BarryPSmith/SierraGliding/README.md

<h1 align=center>Sierra Gliding Weather</h1>

<p align=center>Low Interval Wind Station</p>
