BarryPSmith/SierraGliding/RemoteStation/README.md

Arduino code for the weather stations. Needs cleanup.

Git hash is stored in revid.h. This file is automatically generated by gitver.cmd or gitver.sh.
