BarryPSmith/SierraGliding/docs/img/Solar_panel_1.jpg

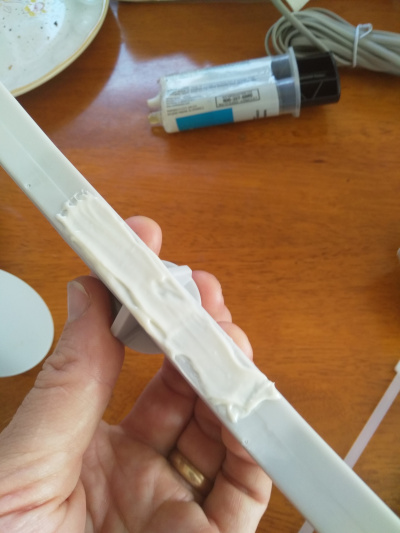
docs/img/Solar_panel_1.jpg
