BarryPSmith/SierraGliding/docs/img/Magnet Installation.jpg

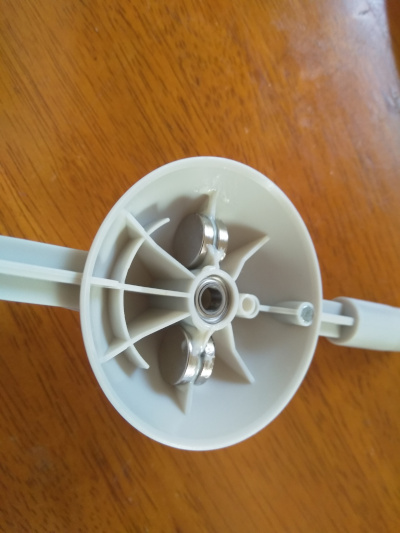
docs/img/Magnet Installation.jpg
