BarryPSmith/SierraGliding/(threads)

Thread 2 (2019-10-12):

Websockets close without traffic

BarryPSmith, 2019-10-12:
Websockets seem to close themselves after a short while without traffic. This might happen if something goes wrong with the server receiving data, or on mobile if the device is put to sleep.

Perhaps have the client periodically check if the websocket has closed and reopen it if necessary

Closed 2020-02-18.
