BarryPSmith/SierraGliding/hardware/main_board/Single_Board.brd

## EAGLE design hardware/main_board/Single_Board.brd (2021-05-05)

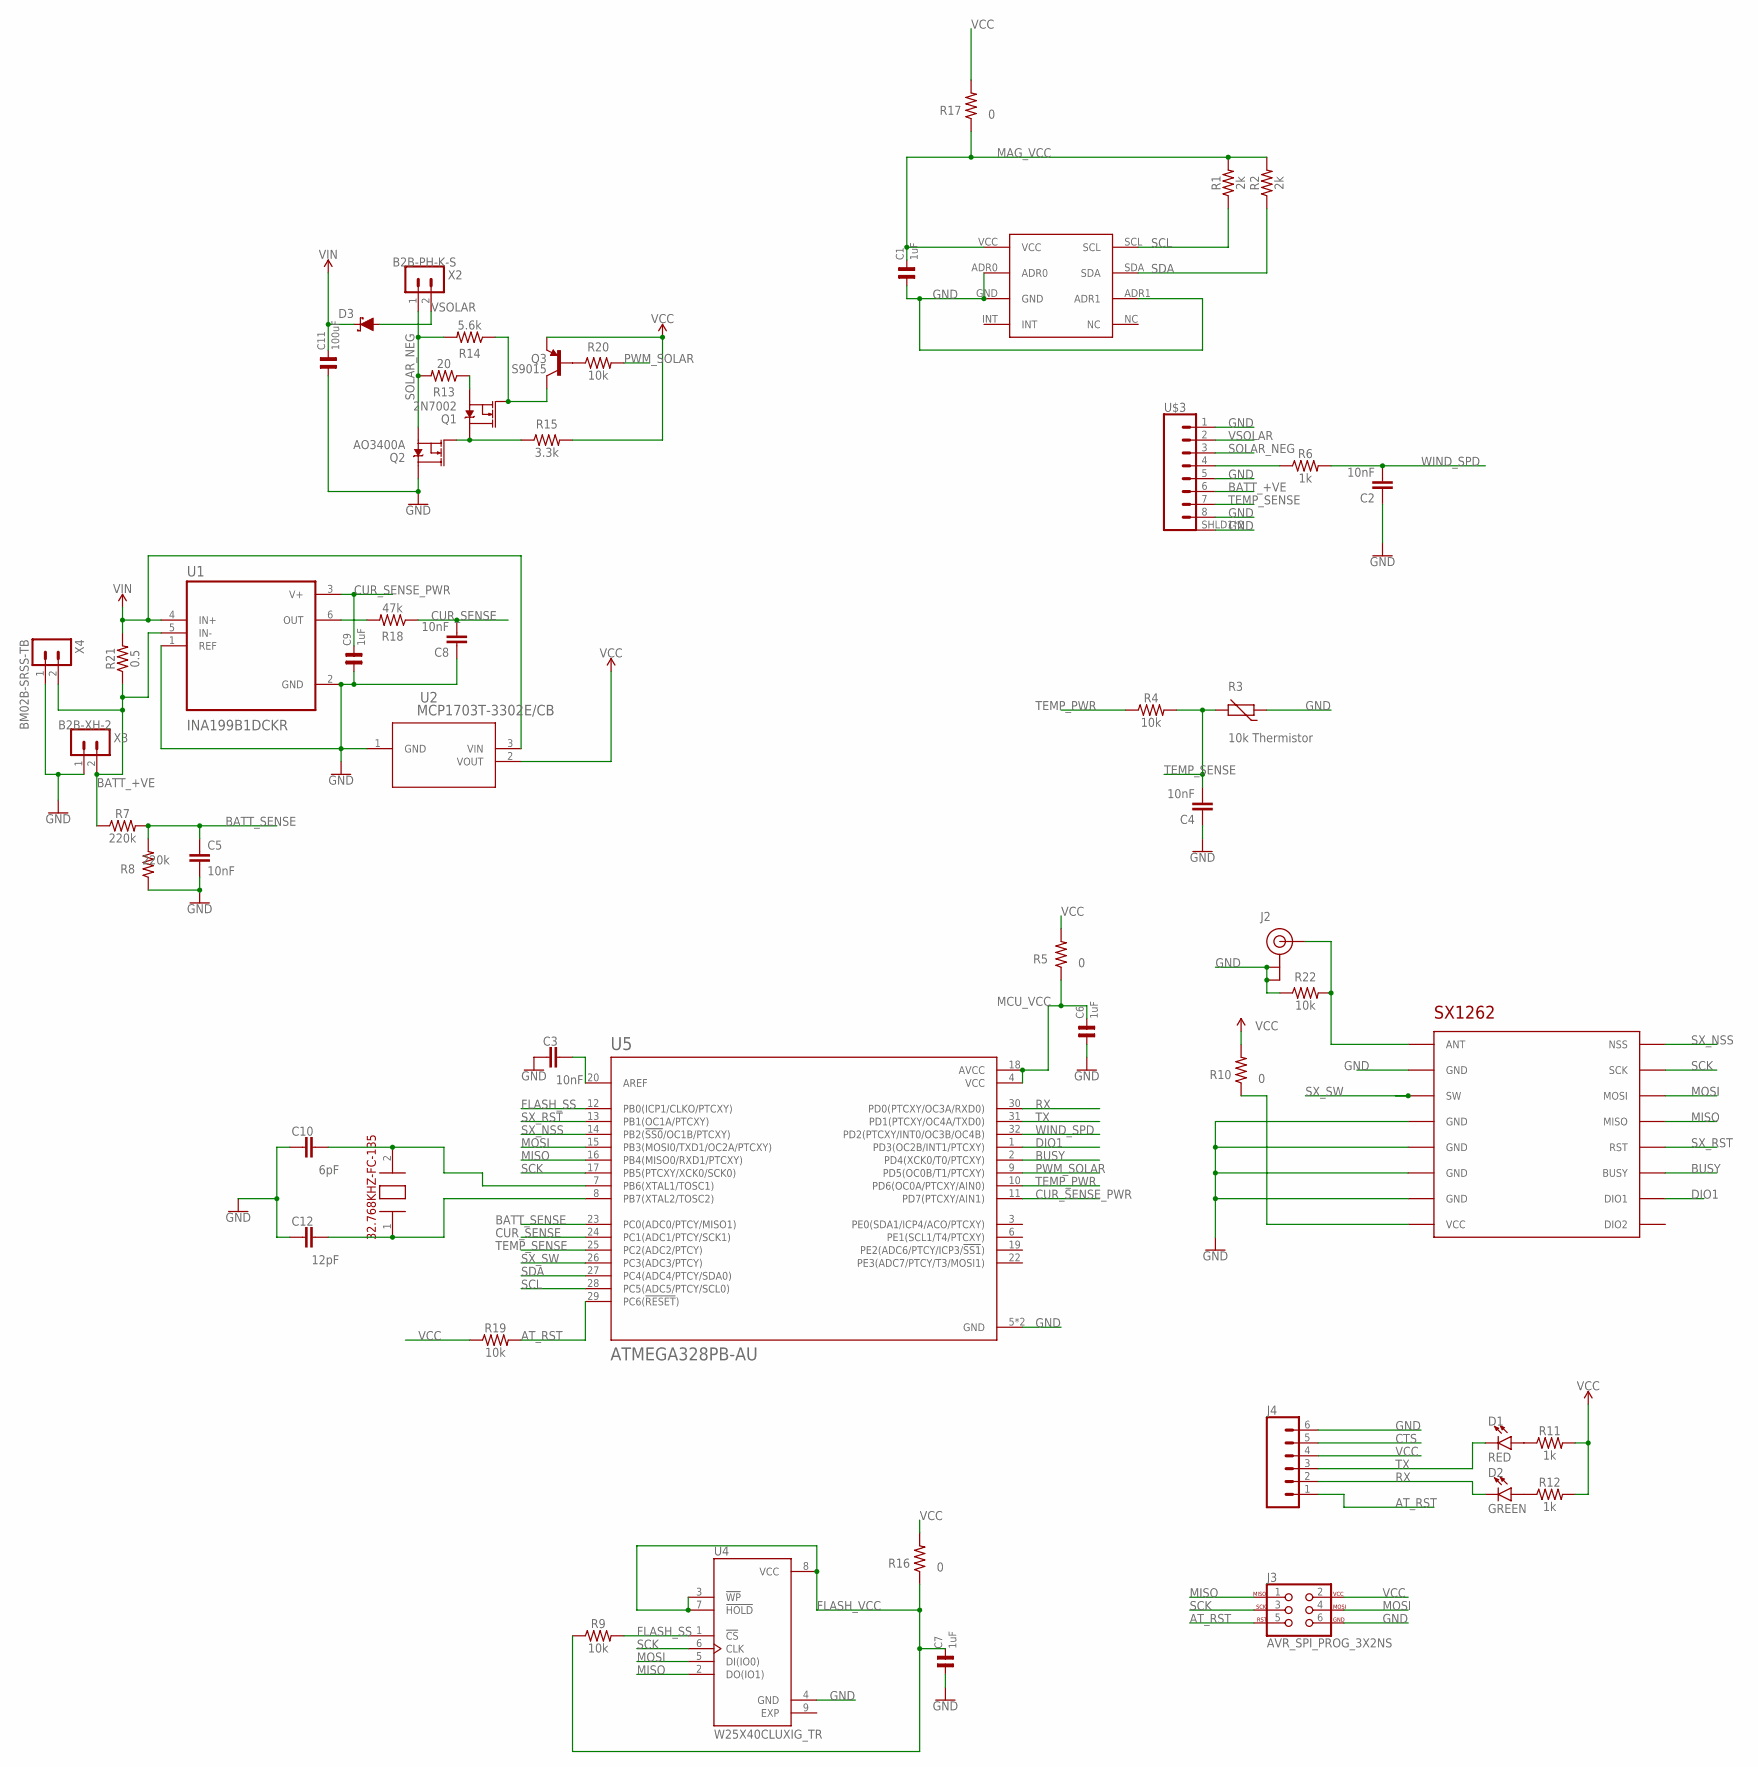
[picture p10: schematic Single_Board.sch]

Parts:
C1, C6, C7, C9: 1uF; 0805
C2, C3, C4, C5, C8: 10nF; 0603
C10: 6pF; 0603
C11: 100uF; 1206
C12: 12pF; 0603
D1: RED; LED-1206
D2: GREEN; LED-1206
D3: NSR0240HT1G; SOD-323
J2: U.FL
J3: AVR_SPI_PROG_3X2NS; 2X3-NS
J4: CONN_06NO_SILK_FEMALE_PTH; 1X06_NO_SILK
Q1: 2N7002; SOT23-3
Q2: AO3400A; SOT23-3
Q3: S9015; SOT23-3
R1, R2: 2k; 0805
R3: 10k Thermistor; R-5
R4, R9, R19, R20, R22: 10k; 0805
R5, R10, R16, R17: 0; 0805
R6, R11, R12: 1k; 0805
R7, R8: 220k; 0805
R13: 20; 0805
R14: 5.6k; 0805
R15: 3.3k; 0805
R18: 47k; 0805
R21: 0.5; 1206
U1: INA199B1DCKR; SOT65P210X110-6N
U2: MCP1703T-3302E/CB; SOT-23A_MC
U4: W25X40CLUXIG_TR; PSON50P300X200X60-9N
U5: ATMEGA328PB-AU; QFP80P900X900X120-32N
U$1: ALS31313; ALS31313-500
U$2: SX1262
U$3: RJSHE3380; RJHSE-3380
X1: 32.768KHZ-FC-135
X2: B2B-PH-K-S
X3: B2B-XH-2; B2B-XH-A
X4: BM02B-SRSS-TB

Connections:
ANT: J2.FEED (SIGNAL), R22.2, U$2.ANT
AT_RST: J3.5, J4.1, R19.2, U5.29 (PC6(!RESET!))
BATT_+VE: R7.1, R21.1, U1.5 (IN-), U$3.6, X3.2, X4.2
BATT_SENSE: C5.1, R7.2, R8.2, U5.23 (PC0(ADC0/PTCY/MISO1))
BUSY: U5.2 (PD4(XCK0/T0/PTCXY)), U$2.BUSY
CTS: J4.5
CUR_SENSE: C8.2, R18.1, U5.24 (PC1(ADC1/PTCY/SCK1))
CUR_SENSE_PWR: C9.2, U1.3 (V+), U5.11 (PD7(PTCXY/AIN1))
DIO1: U5.1 (PD3(OC2B/INT1/PTCXY)), U$2.DIO1
EXP: U4.9 (EXP)
FLASH_SS: R9.2, U4.1 (!CS), U5.12 (PB0(ICP1/CLKO/PTCXY))
FLASH_VCC: C7.2, R9.1, R16.1, U4.3 (!WP), U4.7 (!HOLD), U4.8 (VCC)
GND: C1.1, C2.1, C3.1, C4.1, C5.2, C6.1, C7.1, C8.1, C9.1, C10.1, C11.1, C12.1, J2.1 (GND), J2.2 (GND), J3.6, J4.6, Q2.3 (D), R3.1, R8.1, R22.1, U1.1 (REF), U1.2 (GND), U2.1 (GND), U4.4 (GND), U5.5 (GND), U5.21 (GND), U$1.ADR0, U$1.ADR1, U$1.GND, U$2.GND@1 (GND), U$2.GND@2 (GND), U$2.GND@3 (GND), U$2.GND@4 (GND), U$2.GND@5 (GND), U$3.1, U$3.5, U$3.8, U$3.SHLD1 (SHLD), U$3.SHLD2 (SHLD), X3.1, X4.1
MAG_VCC: C1.2, R1.2, R2.2, R17.1, U$1.VCC
MCU_VCC: C6.2, R5.1, U5.4 (VCC), U5.18 (AVCC)
MISO: J3.1, U4.2 (DO(IO1)), U5.16 (PB4(MISO0/RXD1/PTCXY)), U$2.MISO
MOSI: J3.4, U4.5 (DI(IO0)), U5.15 (PB3(MOSI0/TXD1/OC2A/PTCXY)), U$2.MOSI
unnamed: R10.1, U$2.VCC
unnamed: C3.2, U5.20 (AREF)
unnamed: Q1.2 (S), R13.1
unnamed: D1.A, R11.1
unnamed: R18.2, U1.6 (OUT)
unnamed: D2.A, R12.1
unnamed: C10.2, U5.7 (PB6(XTAL1/TOSC1)), X1.2 (2.XIN)
unnamed: C12.2, U5.8 (PB7(XTAL2/TOSC2)), X1.1 (1.XIN)
unnamed: Q3.1 (B), R20.1
unnamed: Q1.3 (D), Q2.1 (G), R15.1
unnamed: Q1.1 (G), Q3.3 (C), R14.1
unnamed: R6.1, U$3.4
PWM_SOLAR: R20.2, U5.9 (PD5(OC0B/T1/PTCXY))
RX: D2.C, J4.2, U5.30 (PD0(PTCXY/OC3A/RXD0))
SCK: J3.3, U4.6 (CLK), U5.17 (PB5(PTCXY/XCK0/SCK0)), U$2.SCK
SCL: R1.1, U5.28 (PC5(ADC5/PTCY/SCL0)), U$1.SCL
SDA: R2.1, U5.27 (PC4(ADC4/PTCY/SDA0)), U$1.SDA
SOLAR_NEG: Q2.2 (S), R13.2, R14.2, U$3.3, X2.1
SX_NSS: U5.14 (PB2(!SS0!/OC1B/PTCXY)), U$2.NSS
SX_RST: U5.13 (PB1(OC1A/PTCXY)), U$2.RST
SX_SW: U5.26 (PC3(ADC3/PTCY)), U$2.SW
TEMP_PWR: R4.1, U5.10 (PD6(OC0A/PTCXY/AIN0))
TEMP_SENSE: C4.2, R3.2, R4.2, U5.25 (PC2(ADC2/PTCY)), U$3.7
TX: D1.C, J4.3, U5.31 (PD1(PTCXY/OC4A/TXD0))
VCC: J3.2, J4.4, Q3.2 (E), R5.2, R10.2, R11.2, R12.2, R15.2, R16.2, R17.2, R19.1, U2.2 (VOUT)
VIN: C11.2, D3.C, R21.2, U1.4 (IN+), U2.3 (VIN)
VSOLAR: D3.A, U$3.2, X2.2
WIND_SPD: C2.2, R6.2, U5.32 (PD2(PTCXY/INT0/OC3B/OC4B))

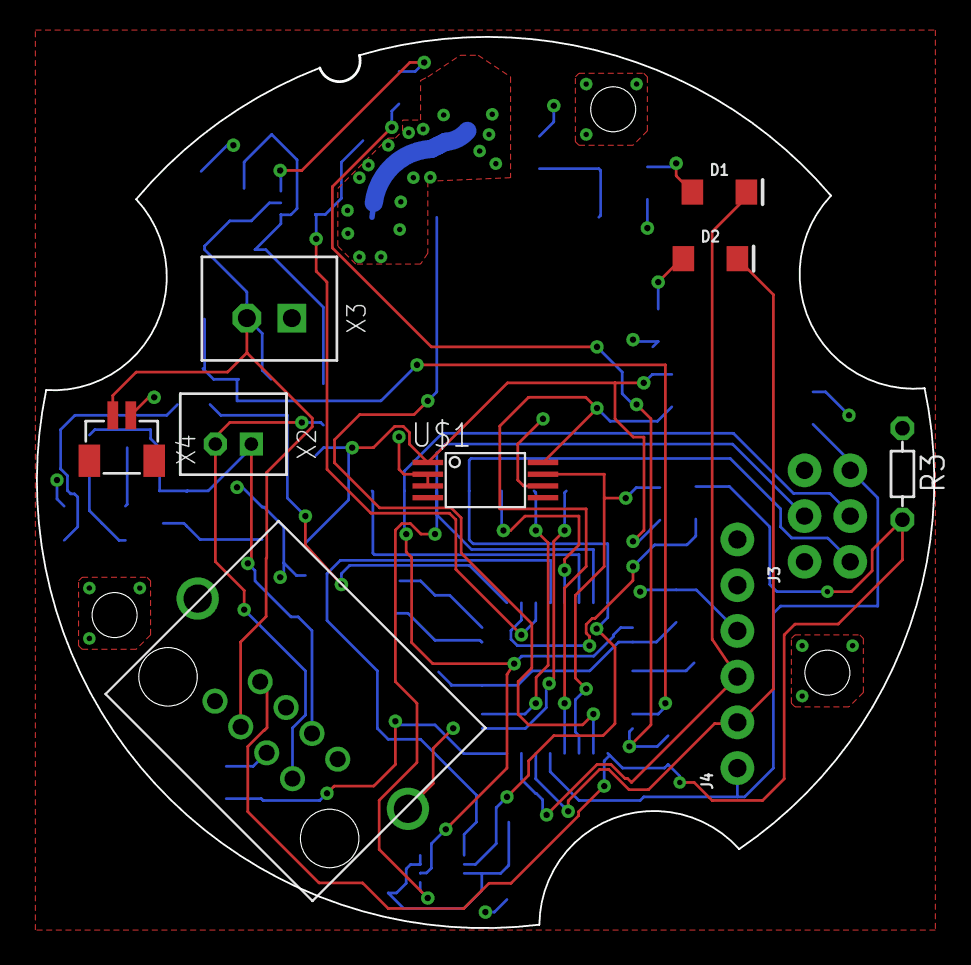
[picture p11: board Single_Board.brd from above]

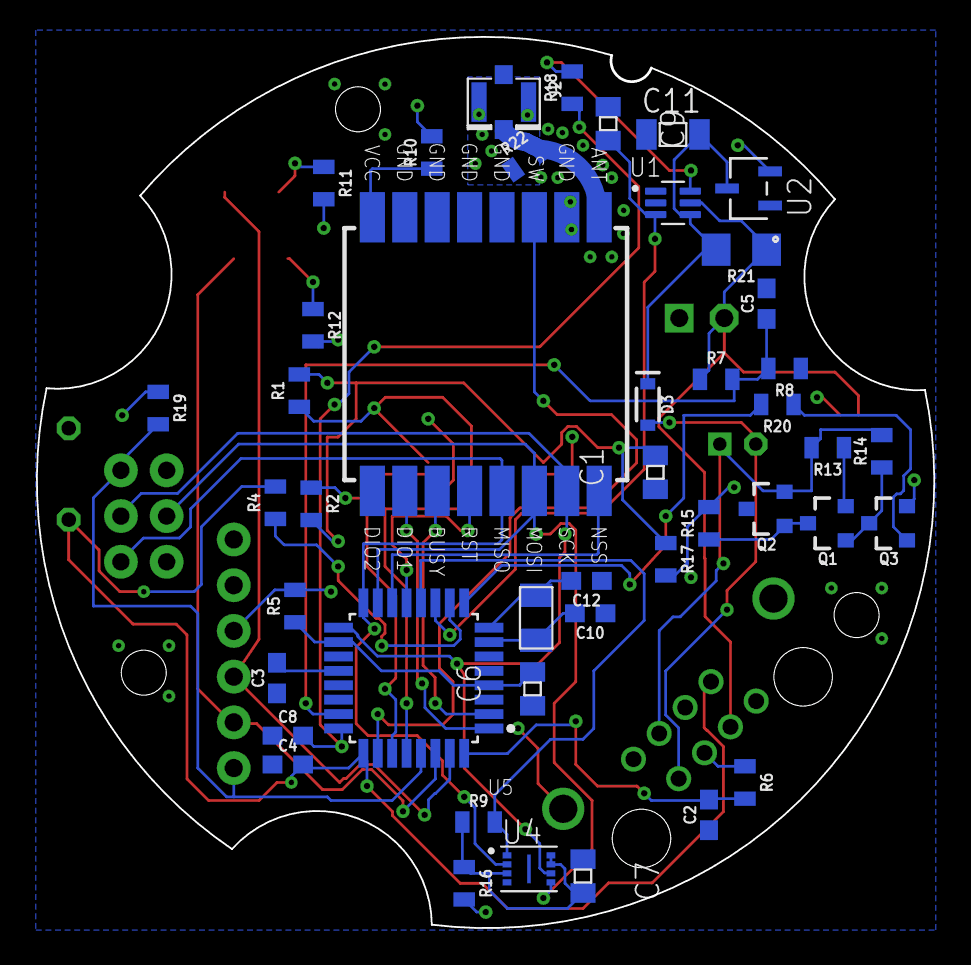
[picture p12: board Single_Board.brd from below]

Board: 2 copper layers, 49.9 x 49.5 mm, 54 parts (44 on the bottom side), 43 nets.
