BarryPSmith/SierraGliding/hardware/main_board/Magnetic Direction Sensor.brd

## EAGLE design hardware/main_board/Magnetic Direction Sensor.brd (2020-05-02)

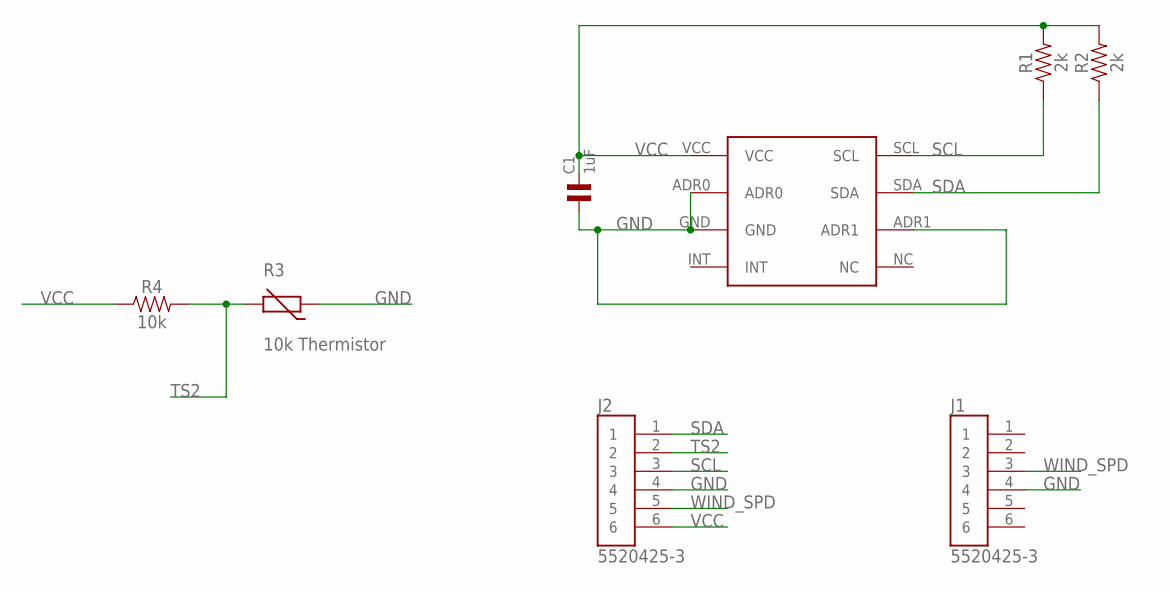
[picture p13: schematic Magnetic Direction Sensor.sch]

Parts:
C1: 1uF; 0805
J1, J2: 5520425-3; TE_5520425-3
R1, R2: 2k; 0805
R3: 10k Thermistor; R-5
R4: 10k; 0805
U$1: ALS31313; ALS31313-500

Connections:
GND: C1.1, J1.4, J2.4, R3.1, U$1.ADR0, U$1.ADR1, U$1.GND
SCL: J2.3, R1.1, U$1.SCL
SDA: J2.1, R2.1, U$1.SDA
TS2: J2.2, R3.2, R4.2
VCC: C1.2, J2.6, R1.2, R2.2, R4.1, U$1.VCC
WIND_SPD: J1.3, J2.5

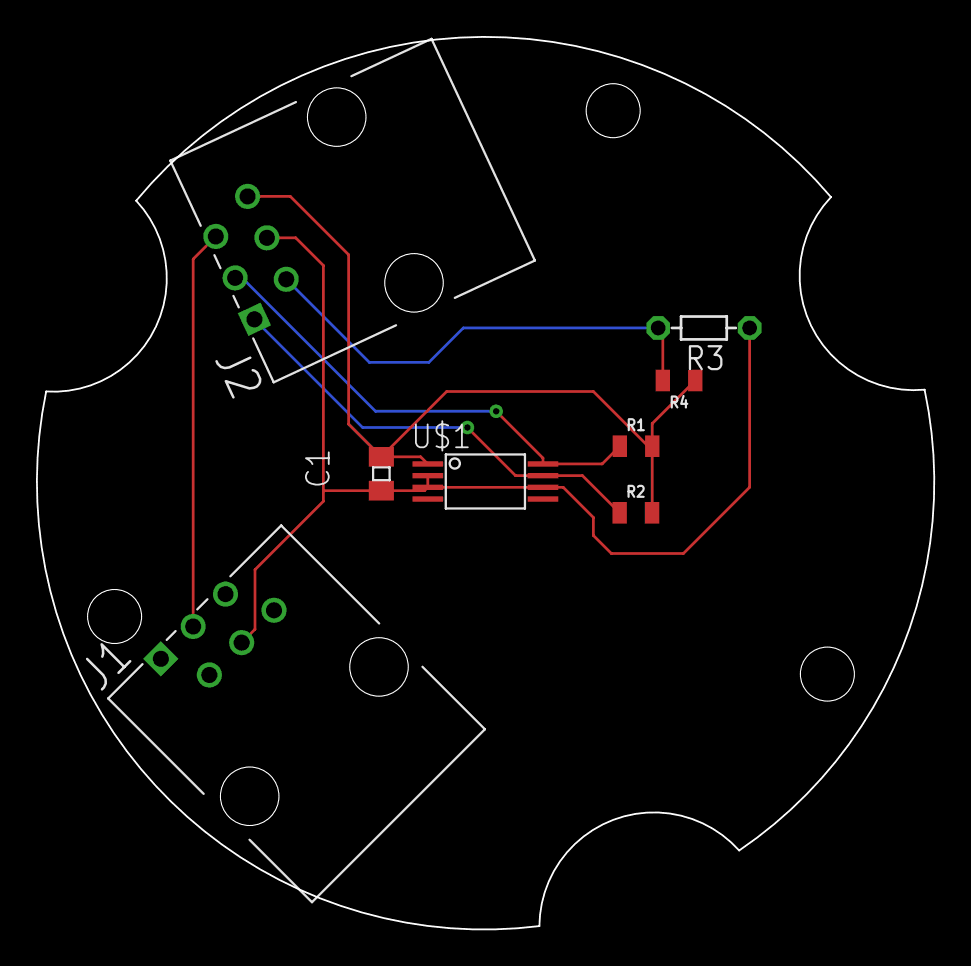
[picture p14: board Magnetic Direction Sensor.brd from above]

Board: 2 copper layers, 49.9 x 49.6 mm, 8 parts (0 on the bottom side), 6 nets.
