BarryPSmith/SierraGliding/hardware/main_board/Weather Station.brd

## EAGLE design hardware/main_board/Weather Station.brd (2020-04-19)

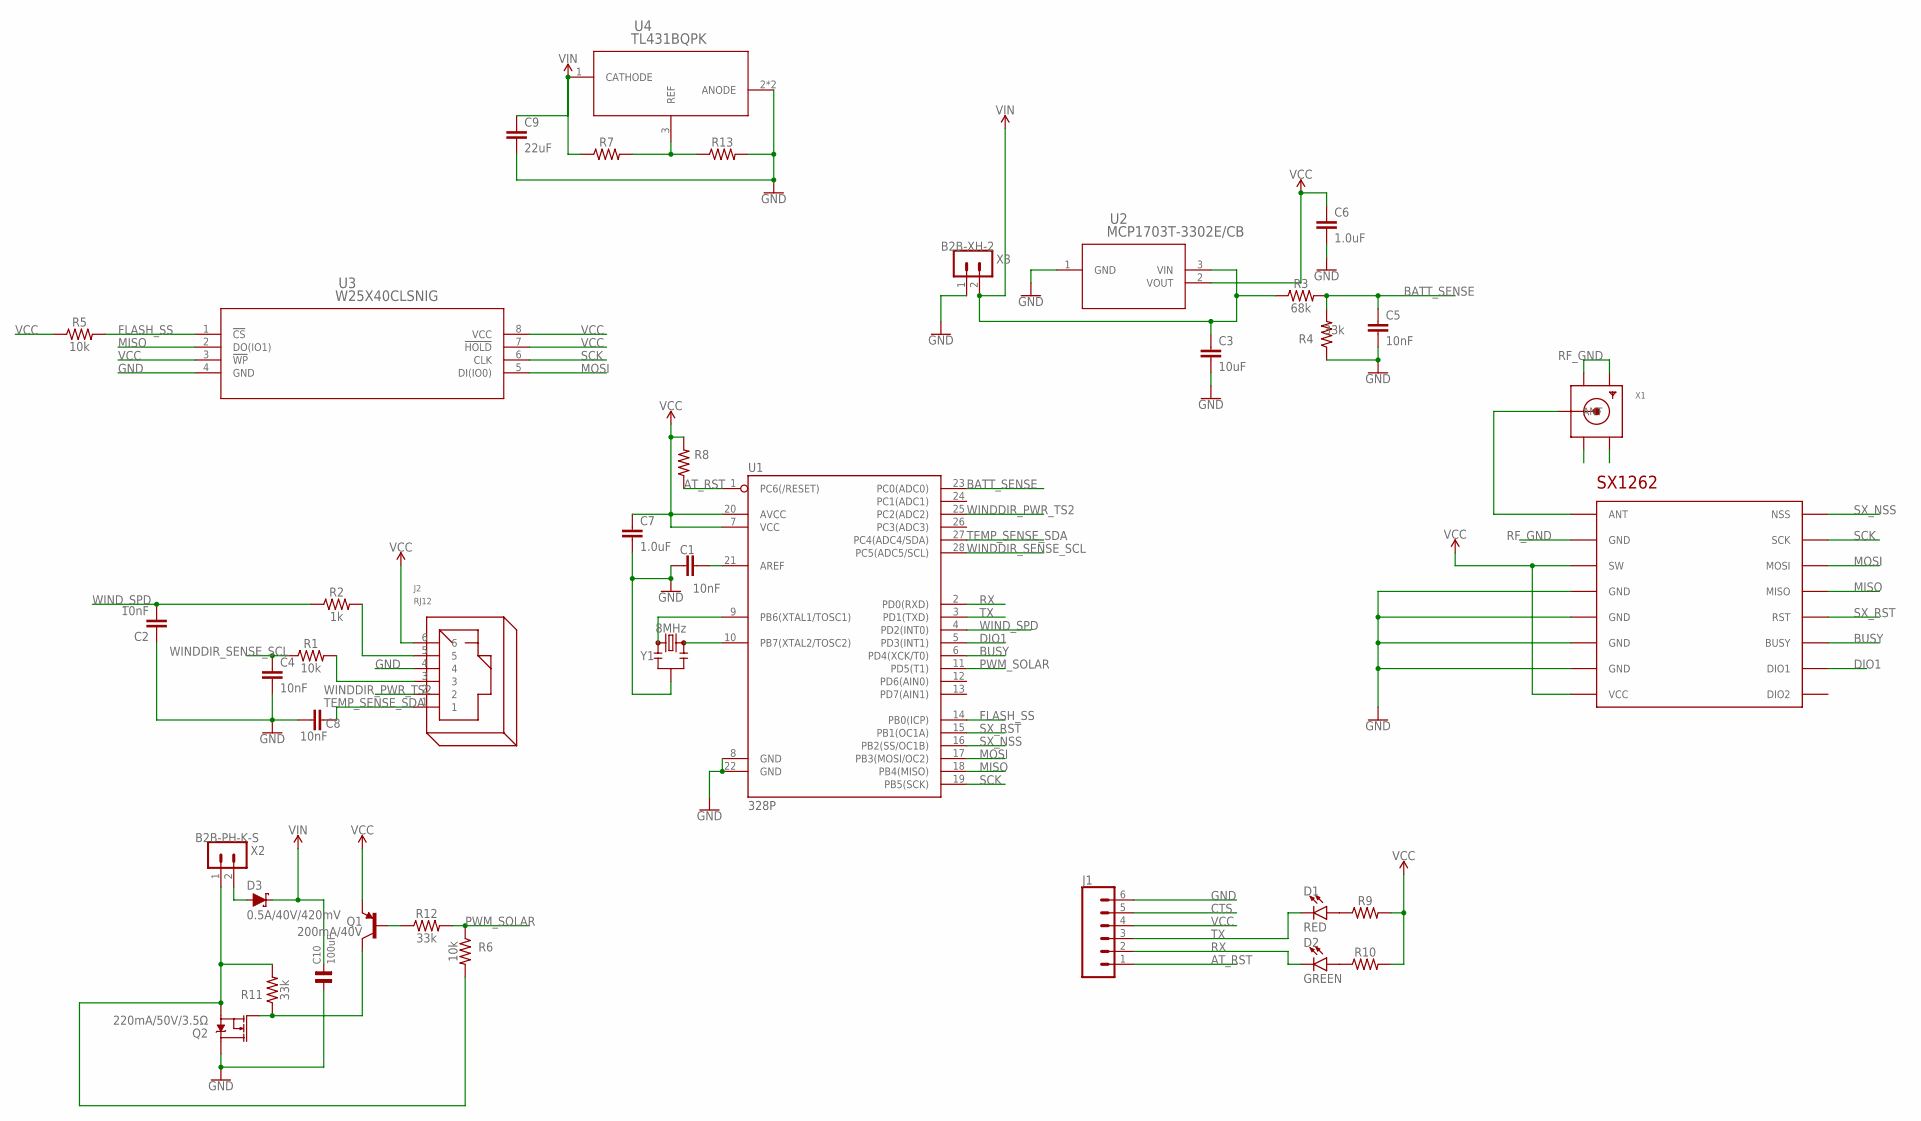
[picture p15: schematic Weather Station.sch]

Parts:
C1, C2, C4, C5, C8: 10nF; 0603
C3: 10uF; 0603
C6: 1.0uF; 0603
C7: 1.0uF; 0805
C9: 22uF; 0805
C10: 100uF; 1206
D1: RED; LED-1206
D2: GREEN; LED-1206
D3: 0.5A/40V/420mV; SOD-323
J1: CONN_06NO_SILK_FEMALE_PTH; 1X06_NO_SILK
J2: RJ12
Q1: 200mA/40V; SOT23-3
Q2: 220mA/50V/3.5Ω; SOT23-3
R1, R5, R6: 10k; 0805
R2: 1k; 0805
R3: 68k; 0805
R4, R11, R12: 33k; 0805
R7, R8, R9, R10, R13: 0805
U1: 328P; DIP28
U2: MCP1703T-3302E/CB; SOT-23A_MC
U3: W25X40CLSNIG; WIN_SN-8
U4: TL431BQPK; PK3
U$1: SX1262
X1: SMACONNECTOR_EDGE_UFL; SMA_EDGELAUNCH_UFL
X2: B2B-PH-K-S
X3: B2B-XH-2; B2B-XH-A
Y1: 8MHz; RESONATOR-SMD-3.2X1.3

Connections:
ANT: U$1.ANT, X1.P (ANT)
AT_RST: J1.1, R8.1, U1.1 (PC6(/RESET))
BATT_SENSE: C5.1, R3.2, R4.2, U1.23 (PC0(ADC0))
BUSY: U1.6 (PD4(XCK/T0)), U$1.BUSY
CTS: J1.5
DIO1: U1.5 (PD3(INT1)), U$1.DIO1
FLASH_SS: R5.2, U1.14 (PB0(ICP)), U3.1 (!CS)
GND: C1.1, C2.1, C3.2, C4.2, C5.2, C6.2, C7.2, C8.2, C9.2, C10.1, J1.6, J2.4, Q2.3 (D), R4.1, R13.2, U1.8 (GND), U1.22 (GND), U2.1 (GND), U3.4 (GND), U4.2 (ANODE), U4.A2 (ANODE), U$1.GND@2 (GND), U$1.GND@3 (GND), U$1.GND@4 (GND), U$1.GND@5 (GND), X3.1, Y1.2
MISO: U1.18 (PB4(MISO)), U3.2 (DO(IO1)), U$1.MISO
MOSI: U1.17 (PB3(MOSI/OC2)), U3.5 (DI(IO0)), U$1.MOSI
unnamed: R7.2, R13.1, U4.3 (REF)
unnamed: J2.5, R2.2
unnamed: D1.A, R9.1
unnamed: D2.A, R10.1
unnamed: J2.3, R1.2
unnamed: C1.2, U1.21 (AREF)
unnamed: Q2.2 (S), R6.2, R11.2, X2.1
unnamed: U1.9 (PB6(XTAL1/TOSC1)), Y1.1
unnamed: U1.10 (PB7(XTAL2/TOSC2)), Y1.3
unnamed: Q1.3 (C), Q2.1 (G), R11.1
unnamed: Q1.1 (B), R12.1
unnamed: D3.A, X2.2
PWM_SOLAR: R6.1, R12.2, U1.11 (PD5(T1))
RF_GND: U$1.GND@1 (GND), X1.GND@1 (GND1), X1.GND@2 (GND2)
RX: D2.C, J1.2, U1.2 (PD0(RXD))
SCK: U1.19 (PB5(SCK)), U3.6 (CLK), U$1.SCK
SX_NSS: U1.16 (PB2(SS/OC1B)), U$1.NSS
SX_RST: U1.15 (PB1(OC1A)), U$1.RST
TEMP_SENSE_SDA: C8.1, J2.1, U1.27 (PC4(ADC4/SDA))
TX: D1.C, J1.3, U1.3 (PD1(TXD))
VCC: C6.1, C7.1, J1.4, J2.6, Q1.2 (E), R5.1, R8.2, R9.2, R10.2, U1.7 (VCC), U1.20 (AVCC), U2.2 (VOUT), U3.3 (!WP), U3.7 (!HOLD), U3.8 (VCC), U$1.SW, U$1.VCC
VIN: C3.1, C9.1, C10.2, D3.C, R3.1, R7.1, U2.3 (VIN), U4.1 (CATHODE), X3.2
WINDDIR_PWR_TS2: J2.2, U1.25 (PC2(ADC2))
WINDDIR_SENSE_SCL: C4.1, R1.1, U1.28 (PC5(ADC5/SCL))
WIND_SPD: C2.2, R2.1, U1.4 (PD2(INT0))

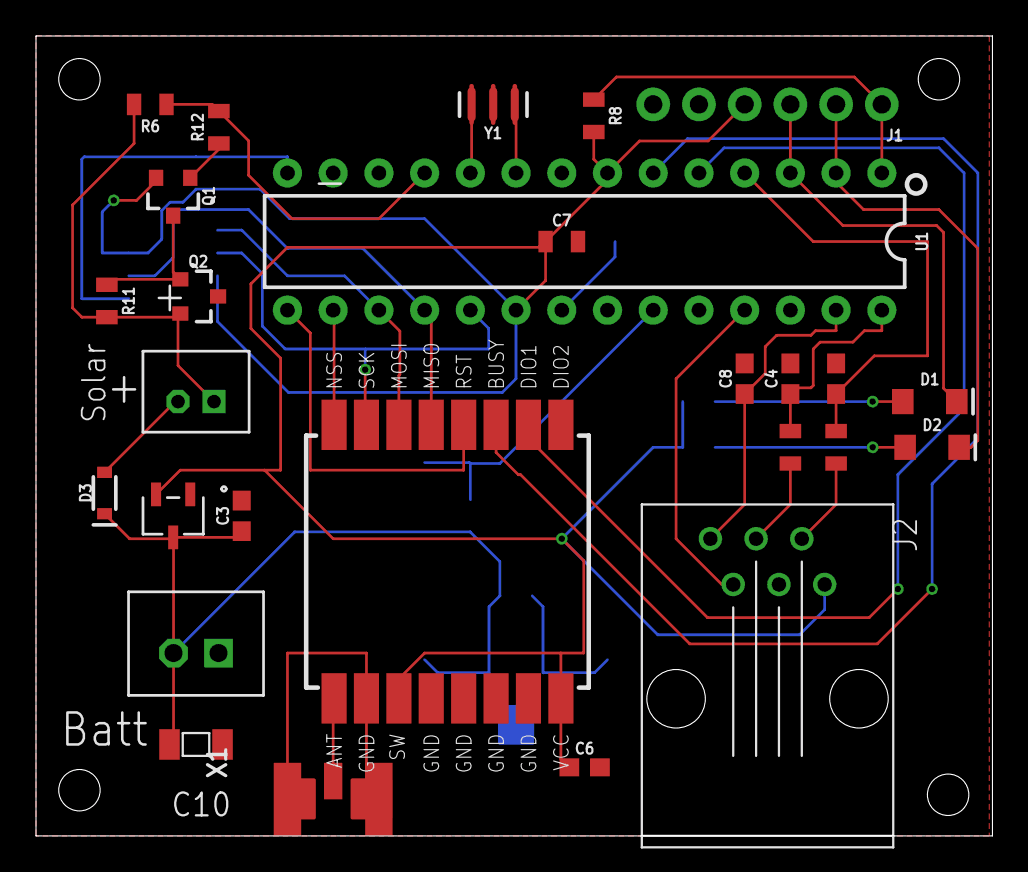
[picture p16: board Weather Station.brd from above]

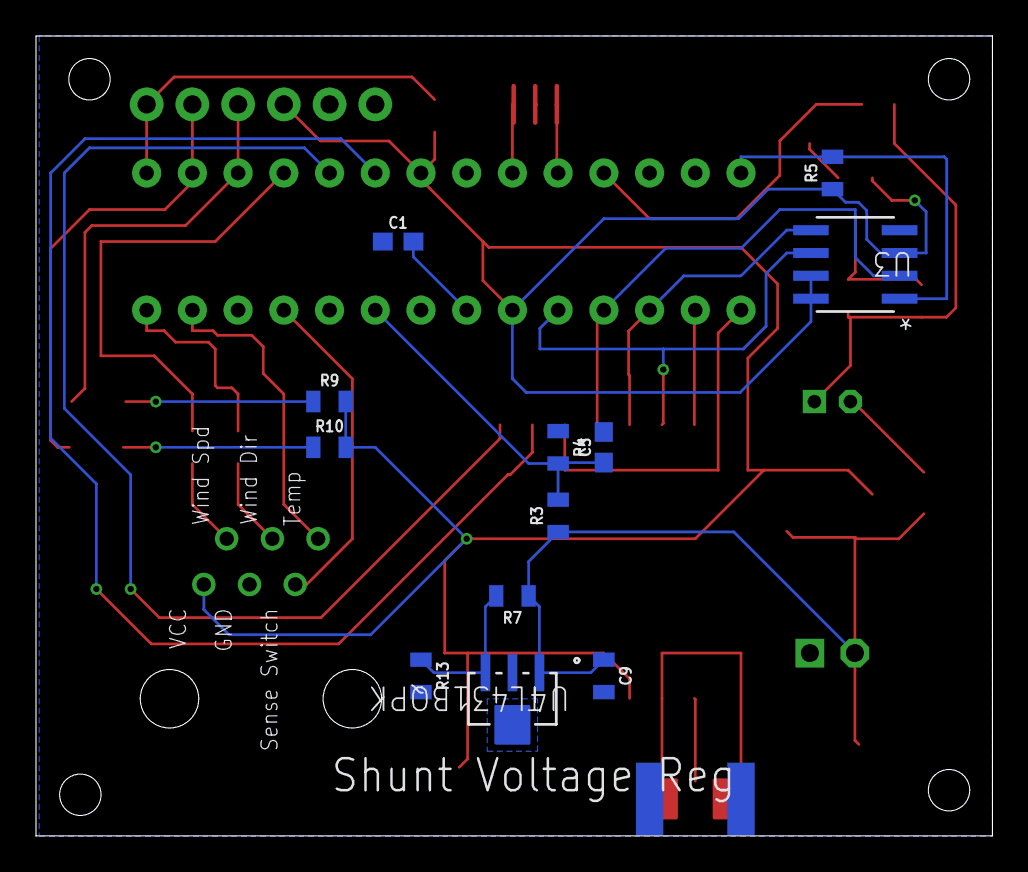
[picture p17: board Weather Station.brd from below]

Board: 2 copper layers, 53.1 x 44.4 mm, 39 parts (12 on the bottom side), 34 nets.
