BarryPSmith/SierraGliding/RemoteStation/Database.cpp

#include "Database.h"
#include "Flash.h"
#include "TimerTwo.h"
#include "LoraMessaging.h"
#include "MessageHandling.h"
#include "ArduinoWeatherStation.h"

#ifndef NO_STORAGE

#ifdef DEBUG_DATABASE
#define DATABASE_PRINTLN AWS_DEBUG_PRINTLN
#define DATABASE_PRINTVAR PRINT_VARIABLE
#define DATABASE_DEBUG AWS_DEBUG
#else
#define DATABASE_PRINTLN(...) do {} while (0)
#define DATABASE_PRINTVAR(...) do {} while (0)
#define DATABASE_DEBUG(...) do {} while (0)
#endif

// Total available memory is 512kB
// At 256 bytes per message, could store 2k messages

// Fat table:
// Every 4k sector will have:
// MSG (Cur Cycle: 1 byte) - 4 bytes
// Message records (12b each) - 341 per sector
// With 6 sectors, we can store 2046 messages.
// (Maximum requirement of 523 776 bytes to store all those messages)

extern void* operator new(size_t size, void* ptr);

namespace Database
{
  struct MessageRecord
  {
    byte messageType; // 1
    byte stationID; // 1
    unsigned long address; // 4
    byte length; // 1
    unsigned long timestamp; // 4
    byte isValid; // 1
  };

  constexpr unsigned long totalMemory = 512ul * 1024;

  constexpr unsigned short blockSize = 4096;
  constexpr unsigned long messageFatStart = 32768;
  constexpr unsigned short messageFatLen = blockSize * 8; // 32 kB - 2700 messages worth of headers (12 bytes per header)
  constexpr unsigned long messageFatEnd = messageFatStart + messageFatLen;
  constexpr unsigned long messageDataStart = messageFatEnd;
  constexpr unsigned long messageDataLen = totalMemory - messageDataStart;
  constexpr unsigned long messageDataEnd = messageDataStart + messageDataLen; // 450 kB - about enough for 1800 full size messages
  constexpr unsigned short maxProcessingTime = 1000;
  constexpr unsigned short minMessageInterval = 1000;

  const char MSG[] = { 'M', 'S', 'G' };

  constexpr byte maxMesagesToRead = 256 / sizeof(MessageRecord);
  constexpr byte recordBufferSize = maxMesagesToRead * sizeof(MessageRecord);
  
  unsigned long findCurrentBlock();
  bool checkEndsOfBlocks(byte byteCount);
  byte getHeaderChunk(void* buffer);
  MESSAGE_RESULT appendRecord(LoraMessageDestination& searchMessage,
    const MessageRecord& record, const unsigned short address);
  void doSearch();
  void startSearch(byte typeFilter, byte sourceFilter);
  void endSearch();
  bool retrieveMessage(const unsigned short headerAddress,
    byte uniqueID);

  unsigned long _curHeaderAddress;
  unsigned long _curWriteAddress = messageDataStart;
  byte _curCycle = 0;
  bool _databaseOK = false;

  unsigned long _curSearchAddress;
  byte _messageTypeFilter;
  byte _messageSourceFilter;
  /*byte _outgoingMessageBytes[254];
  byte _outgoingMessageBuffer[sizeof(LoraMessageDestination)];
  LoraMessageDestination* _searchMessage;*/
  unsigned long _lastSearchMessageMillis = 0;
  unsigned long _cleanAddressStart = 0;
  unsigned long _cleanAddressFat = 0;


  void initDatabase()
  {
    Flash::flash.wakeup();
    MessageRecord buffer[maxMesagesToRead];
    unsigned long blockStart = findCurrentBlock();
    unsigned long curAddress = blockStart + (sizeof(MSG) + 1);
    unsigned long blockEnd = blockStart + blockSize;
    for (; curAddress < blockEnd; curAddress += sizeof(buffer))
    {
      //DATABASE_PRINTVAR(curAddress);
      byte readSize = sizeof(buffer);
      unsigned long endAddress = curAddress + readSize;
      if (endAddress > blockEnd)
        readSize = blockEnd - curAddress;
      Flash::flash.readBytes(curAddress, buffer, readSize);
      MessageRecord* record = buffer;
      bool endFound = false;
      for (; record < buffer + readSize / sizeof(MessageRecord); record++) 
      {
        if (record->messageType == 0xFF)
        {
          endFound = true;
          break;
        }
      }
      byte recordsRead = record - buffer;
      DATABASE_PRINTVAR(recordsRead);
      if (recordsRead > 0)
      {
        record--;
        _curWriteAddress = record->address + record->length;
      }
      _curHeaderAddress = curAddress + recordsRead * sizeof(MessageRecord);
      if (endFound)
        break;
    }
    _databaseOK = true;
    DATABASE_PRINTVAR(blockStart);
    DATABASE_PRINTVAR(_curWriteAddress);
    DATABASE_PRINTVAR(_curHeaderAddress);
    Flash::flash.sleep();
  }

  unsigned long findCurrentBlock()
  {
    bool lastBlockInitialised = true;
    byte buffer[sizeof(MSG) + 1];
    unsigned long blockStart = messageFatStart;
    for (; blockStart < messageFatEnd; blockStart += blockSize)
    {
      Flash::flash.readBytes(blockStart, buffer, sizeof(MSG) + 1);
      lastBlockInitialised = memcmp(buffer, MSG, sizeof(MSG)) == 0;
      if (!lastBlockInitialised)
      {
        //We've found an uninitialised block. The previous block was the active block.
        break;
      }
      byte blockCycle = buffer[sizeof(MSG)];
      if (blockStart != messageFatStart && blockCycle != _curCycle + 1)
      {
        //We've found a block that doesn't fit. The previous block was the active block
        break;
      }
      else
        _curCycle = blockCycle;
    }
    //DATABASE_PRINTVAR(lastBlockInitialised);
    if (blockStart > messageFatStart)
      blockStart -= blockSize;
    else if (!lastBlockInitialised) // initialise the first block
    {
      Flash::flash.blockErase4K(blockStart);
      byte initBuffer[] = {'M', 'S', 'G', 0 };
      Flash::flash.writeBytes(blockStart, initBuffer, sizeof(initBuffer));
    }
    return blockStart;
  }

  void storeMessage(byte messageType, byte stationID,
    MessageSource& msg)
  {
    byte byteCount = msg.getMessageLength() - msg.getCurrentLocation();
    byte* buffer;
    if (msg.accessBytes(&buffer, byteCount))
      return;
    storeData(messageType, stationID, buffer, byteCount);
  }

  void storeData(byte messageType, byte stationID,
    byte* buffer, byte byteCount)
  {
    DATABASE_PRINTLN(F("StoreMessage: Enter"));

    Flash::flash.wakeup();
    if (!checkEndsOfBlocks(byteCount))
    {
      Flash::flash.sleep();
      return;
    }

    MessageRecord headerRecord = {
      .messageType = messageType,
      .stationID = stationID,
      .address = _curWriteAddress,
      .length = byteCount,
      .timestamp = TimerTwo::seconds(),
      .isValid = 0xFF
    };

    DATABASE_PRINTVAR(_curHeaderAddress);
    //DATABASE_PRINTVAR(sizeof(headerRecord));
    //DATABASE_PRINTVAR((int)&headerRecord);
    //DATABASE_PRINTLN(F("StoreMessage: pre-write header"));
    Flash::flash.writeBytes(_curHeaderAddress, &headerRecord, sizeof(headerRecord));
    _curHeaderAddress += sizeof(headerRecord);

    //DATABASE_PRINTLN(F("StoreMessage: pre-write data"));
    Flash::flash.writeBytes(_curWriteAddress, buffer, byteCount);
    _curWriteAddress += byteCount;
    Flash::flash.sleep();
  }

  bool checkEndsOfBlocks(byte messageSize)
  {
    unsigned long endHeaderAddress = _curHeaderAddress + sizeof(MessageRecord);
    bool initFirstHeaderBlock = false;
    if (endHeaderAddress > messageFatEnd)
    {
      initFirstHeaderBlock = true;
      _curHeaderAddress = messageFatStart;
      endHeaderAddress = messageFatStart + sizeof(MessageRecord);
    }
    unsigned short endInBlock = endHeaderAddress % blockSize;
    if (initFirstHeaderBlock || (endInBlock != 0 && endInBlock < sizeof(MessageRecord)))
    {
      _curHeaderAddress = endHeaderAddress - endInBlock;
      Flash::flash.blockErase4K(_curHeaderAddress);
      byte initBuffer[] = {'M', 'S', 'G', ++_curCycle };
      Flash::flash.writeBytes(_curHeaderAddress, initBuffer, sizeof(initBuffer));
      _curHeaderAddress += sizeof(initBuffer);
    }

    unsigned long endMessageAddress = _curWriteAddress + messageSize;
    bool initFirstDataBlock = false;
    if (endMessageAddress > messageDataEnd)
    {
      initFirstDataBlock = true;
      _curWriteAddress = messageDataStart;
      endMessageAddress = messageDataStart + messageSize;
    }
    endInBlock = endMessageAddress % blockSize;
    if (initFirstDataBlock || (endInBlock != 0 && endInBlock < messageSize))
    {
      _curWriteAddress = endMessageAddress - endInBlock;
      Flash::flash.blockErase4K(_curWriteAddress);
      //TODO: Update the FAT to indicate that we've overwritten the block.
    }

    return true;
  }

  enum class ProcessingActions
  {
    Idle, Searching, Cleaning
  };
  ProcessingActions _currentAction = ProcessingActions::Idle;
  void doProcessing()
  {
    if (!_databaseOK)
      return;
    switch (_currentAction)
    {
    case ProcessingActions::Idle:
      return;
    case ProcessingActions::Cleaning:
    case ProcessingActions::Searching:
      doSearch();
      break;
    }
  }

  void doSearch()
  {
    if (_currentAction == ProcessingActions::Searching &&
        millis() - _lastSearchMessageMillis < minMessageInterval)
      return;

    //byte msgBuffer[254];
    MessageHandling::_relayNeedsResend = false;
    LoraMessageDestination searchMessage(true, MessageHandling::_relayBuffer, sizeof(MessageHandling::_relayBuffer), 'K', MessageHandling::getUniqueID());
      //LoraMessageDestination::StaticMessage;
    if (_currentAction == ProcessingActions::Searching)
    {
      //searchMessage.initialise('K', MessageHandling::getUniqueID());
      searchMessage.appendByte2('D');
      searchMessage.appendByte2('L');
    }
    bool anyFound = false;

    Flash::flash.wakeup();
    unsigned long entryMillis = millis();
    MessageRecord buffer[maxMesagesToRead];
    bool noOverrun = true;
    while (millis() - entryMillis > maxProcessingTime && noOverrun)
    {
      byte bytesRead = getHeaderChunk(buffer);
      unsigned short baseAddress = _curSearchAddress - bytesRead - messageFatStart;
      byte recordsRead = bytesRead / sizeof(MessageRecord);
      if (recordsRead == 0)
      {
        endSearch();
        return;
      }
      for (int i = 0; i < recordsRead; i++)
      {
        unsigned short address = baseAddress + i * sizeof(MessageRecord);
        MessageRecord& record = buffer[i];
        if (record.messageType & 0x80 || record.messageType == 0)
        {
          // Bugfix: Database was failing to write the last message in a block. Finding a hole there should not end the search.
          if (address % blockSize == 4084)
            continue;

          // As the memory is filled up that database wraps around.
          // If we are in the same block as is currently being written, there might be data in the next block.
          byte curSearchBlock = _curSearchAddress / blockSize;
          if (curSearchBlock == _curHeaderAddress / blockSize)
          {
            _curSearchAddress = (curSearchBlock + 1) * blockSize;
            break;
          }
          DATABASE_PRINTLN("End Search");
          DATABASE_PRINTLN(i);
          DATABASE_PRINTLN(_curSearchAddress);
          DATABASE_PRINTLN(record.messageType);
          endSearch();
          return;
        }
        if (!record.isValid)
          continue;
        if (_currentAction == ProcessingActions::Searching)
        {
          if (_messageTypeFilter && (record.messageType != _messageTypeFilter))
            continue;
          if (_messageSourceFilter && (record.stationID != _messageSourceFilter))
            continue;
          anyFound = true;
          switch (appendRecord(searchMessage, record, address))
          {
          case MESSAGE_OK:
            continue;
          case MESSAGE_BUFFER_OVERRUN:
            _curSearchAddress = messageFatStart + address;
            noOverrun = false;
            break;
          default:
            SIGNALERROR(DATABASE_UNKNOWN_CUR_ACTION);
            endSearch();
            return;
          }
        }
        else
        {
          unsigned long recordAddress = messageFatStart + address;
          // If the record points to erased data,
          if (_cleanAddressStart <= record.address && record.address < _cleanAddressStart + blockSize
            // and the record is not recently written
            && recordAddress - _cleanAddressFat > 240)
            // update the fact that the record is erased.
          {
            Flash::flash.writeByte(recordAddress + 11, 0);
          }
        }
      }
    }
    if (_currentAction == ProcessingActions::Searching)
    {
      if (!anyFound)
      {
        // Disable sleep so we do this loop again immediately
        dbSleepEnabled = SleepModes::disabled;
        searchMessage.abort();
      }
      else
      {
        dbSleepEnabled = SleepModes::powerSave;
        _lastSearchMessageMillis = millis();
      }
    }
    else
      searchMessage.abort();
    Flash::flash.sleep();
  }

  MESSAGE_RESULT appendRecord(LoraMessageDestination& searchMessage,
    const MessageRecord& record, const unsigned short address)
  {
    MESSAGE_RESULT ok = searchMessage.appendT(record.messageType); //1
    if (ok == MESSAGE_OK) ok = searchMessage.appendT(record.stationID); //1
    if (ok == MESSAGE_OK) ok = searchMessage.appendT(record.timestamp); //4
    if (ok == MESSAGE_OK) ok = searchMessage.appendT(address); //2
    return ok;
  }

  byte getHeaderChunk(void* buffer)
  {
    unsigned short locInBlock = _curSearchAddress % blockSize;
    unsigned short bytesToNextBlock = blockSize - locInBlock;
    bool unusedEnd = bytesToNextBlock < sizeof(MessageRecord);
    if (unusedEnd)
    {
      _curSearchAddress += bytesToNextBlock;
      locInBlock = 0;
    }
    if (locInBlock < 4)
    {
      _curSearchAddress -= locInBlock;
      if (_curSearchAddress >= messageFatEnd)
        return 0;
      byte blockHeaderBuffer[3];
      Flash::flash.readBytes(_curSearchAddress, blockHeaderBuffer, 3);
      if (memcmp(blockHeaderBuffer, MSG, 3))
        return 0;
      _curSearchAddress += 4;
      bytesToNextBlock = blockSize - 4;
    }
    byte bytesToRead = recordBufferSize;
    if (bytesToRead > bytesToNextBlock)
      bytesToRead = (bytesToNextBlock / sizeof(MessageRecord)) * sizeof(MessageRecord);
    Flash::flash.readBytes(_curSearchAddress, buffer, bytesToRead);
    _curSearchAddress += bytesToRead;
    return bytesToRead;
  }

  void startClean(unsigned long dataStart, unsigned long fatStart)
  {
    _cleanAddressFat = fatStart;
    _cleanAddressStart = dataStart;
    _currentAction = ProcessingActions::Cleaning;
  }

  void startSearch(byte typeFilter, byte sourceFilter)
  {
    _messageTypeFilter = typeFilter;
    _messageSourceFilter = sourceFilter;
    _curSearchAddress = messageFatStart + 4;
    _currentAction = ProcessingActions::Searching;
    // Ensure that we wait before we start to send the search results.
    // Otherwise our results will likely collide with the relay of our acknowledge
    _lastSearchMessageMillis = millis(); 
  }

  void endSearch()
  {
    _currentAction = ProcessingActions::Idle;
    dbSleepEnabled = SleepModes::powerSave;
  }

  bool handleDatabaseCommand(MessageSource& msg, const byte uniqueID,
    bool* ackRequired)
  {
    if (!_databaseOK)
      return false;
    byte cmdType;
    if (msg.readByte(cmdType))
      return false;
    switch (cmdType)
    {
    case 'L': //List
      {
        byte typeFilter = 0;
        byte sourceFilter = 0;
        if (msg.readByte(typeFilter) == MESSAGE_OK)
          msg.readByte(sourceFilter);
        startSearch(typeFilter, sourceFilter);
        return true;
      }
    case 'R': //Retrieve
      unsigned short address;
      if (msg.read(address))
        return false;
      *ackRequired = false;
      return retrieveMessage(address, uniqueID);
    }
    return false;
  }

  bool retrieveMessage(const unsigned short headerAddress,
    byte uniqueID)
  {
    Flash::flash.wakeup();
    unsigned long hAddress = messageFatStart + headerAddress;
    if (hAddress > messageFatEnd)
      return false;
    MessageRecord record;
    Flash::flash.readBytes(hAddress, &record, sizeof(record));
    if (record.messageType & 0x80  || record.messageType == 0 ||
        record.address < messageDataStart || record.address >= messageDataEnd)
      return false;
    byte msgBuffer[254];
    LoraMessageDestination dest(false, msgBuffer, sizeof(msgBuffer), 'K', uniqueID);
    dest.appendByte2('D');
    dest.appendByte2('R');
    dest.appendByte2(record.messageType);
    dest.appendByte2(record.stationID);
    dest.appendByte2(0);
    byte* buffer;
    byte maxSize = sizeof(msgBuffer) - dest.getCurrentLocation();
    if (maxSize > record.length)
      maxSize = record.length;
    if (dest.getBuffer(&buffer, maxSize))
      return false;
    Flash::flash.readBytes(record.address, buffer, maxSize);
    return true;
    Flash::flash.sleep();
  }
}

#endif // NO_STORAGE
