BarryPSmith/SierraGliding/RemoteStation/WeatherProcessing/WeatherProcessing.h

#pragma once
#include "../LoraMessaging.h"
#include "../ArduinoWeatherStation.h"

#ifdef DEBUG_WEATHER
#define WX_PRINT AWS_DEBUG_PRINT
#define WX_PRINTLN AWS_DEBUG_PRINTLN
#define WX_PRINTVAR PRINT_VARIABLE
#define WX_DEBUG AWS_DEBUG
#else
#define WX_PRINT(...)  do { } while (0)
#define WX_PRINTLN(...)  do { } while (0)
#define WX_PRINTVAR(...)  do { } while (0)
#define WX_DEBUG(...) do { } while (0)
#endif

#define DUAL_WEATHER (defined(WIND_SPD_PIN) && defined(WS80_WIND))

namespace WeatherProcessing
{
  enum class WeatherDataSource { WS80, Internal };

  extern volatile unsigned short windCounts;

  void setupWeatherProcessing();
  void enterDeepSleep();
  void enterBatterySave();
  void enterNormalMode();
  void setTimerInterval();

  void processWeather();
  void createWeatherData(LoraMessageDestination& message);
  bool handleWeatherCommand(MessageSource& src);
  unsigned short readBattery();
  //ALS only:
#ifdef ALS_WIND
  bool writeAlsEeprom();
  void sleepWind();
  void setWindLowPower();
  void setWindNormal();
#ifdef ALS_FIELD_STRENGTH
  extern unsigned long curFieldSquared;
  extern short curSampleCount;
#endif
#endif

  extern volatile bool weatherRequired;
  extern volatile unsigned short windCounts;

  extern short internalTemperature_x2;
  extern float externalTemperature;

#ifdef WS80_WIND
  void processWeatherWS80();
#endif
}
