BarryPSmith/SierraGliding/RemoteStation/ArduinoWeatherStation.h

#pragma once
#include <Arduino.h>
#include "revid.h"
#include "ErrorCodes.h"

#define STR(A) #A
#define XSTR(A) STR(A)

#ifdef MODEM
#define GET_CRC_FAILURES
#endif

#ifdef DEBUG
#define AWS_DEBUG_PRINT(...) do { \
                    Serial.print(__VA_ARGS__); \
                    } while (0)
#define AWS_DEBUG_PRINTLN(...) do { \
                    Serial.println(__VA_ARGS__);  \
                    } while (0)
#define AWS_DEBUG_WRITE(...) Serial.write(__VA_ARGS__)
#define AWS_DEBUG(...) __VA_ARGS__
#else
#define AWS_DEBUG_PRINT(...) do { } while (0)
#define AWS_DEBUG_PRINTLN(...) do { } while (0)
#define AWS_DEBUG(...) do { } while (0)
#define AWS_DEBUG_WRITE(...) do { } while (0)
#endif

#define PRINT_VARIABLE(a) do { \
  AWS_DEBUG_PRINT(F(#a ": ")); \
  AWS_DEBUG_PRINTLN(a); \
  } while (0)

#define PRINT_VARIABLE_HEX(a) do { \
  AWS_DEBUG_PRINT(F(#a ": ")); \
  AWS_DEBUG_PRINTLN(a, HEX); \
  } while (0)

//#define DEBUG_COMMANDS
//#define DEBUG_TX
//#define DEBUG_RX
//#define DEBUG_DATABASE
//#define DEBUG_MSGPROC
#ifndef  DEBUG_PARAMETERS
#define DEBUG_PARAMETERS
#endif
//#define DEBUG_SOLAR
//#define DEBUG_PROGRAMMING
//#define DEBUG_IT
//#define DEBUG_PWM
#define DEBUG_WEATHER
#ifndef DETAILED_LORA_CHECK
#define DETAILED_LORA_CHECK
#endif
//#define DEBUG_STACK
//#define DEBUG_BASE
//#define DEBUG_FLASH
//#define DEBUG_NO_WEATHER //This is us desperate to get program space.
//#define ALS_FIELD_STRENGTH
#ifdef DEBUG
#undef SOLAR_PWM
#undef CRYSTAL_FREQ
#endif

#ifdef DEBUG_TX
#define TX_PRINT AWS_DEBUG_PRINT
#define TX_PRINTLN AWS_DEBUG_PRINTLN
#define TX_PRINTVAR PRINT_VARIABLE
#define TX_DEBUG AWS_DEBUG
#else
#define TX_PRINT(...) do { } while (0)
#define TX_PRINTLN(...) do { } while (0)
#define TX_PRINTVAR(...) do { } while (0)
#define TX_DEBUG(...) do { } while (0)
#endif

#ifdef DEBUG_RX
#define RX_PRINT AWS_DEBUG_PRINT
#define RX_PRINTLN AWS_DEBUG_PRINTLN
#define RX_PRINTVAR PRINT_VARIABLE
#define RX_DEBUG AWS_DEBUG
#else
#define RX_PRINT(...) do { } while (0)
#define RX_PRINTLN(...) do { } while (0)
#define RX_PRINTVAR(...) do { } while (0)
#define RX_DEBUG(...) do { } while (0)
#endif

#define ver_str "2.7." REV_ID "." XSTR(BOARD)
#define ASW_VER F(ver_str)
#define ver_size (sizeof(ver_str) - 1)

/*extern const PROGMEM char verPM[] = "2.2." REV_ID;
inline constexpr byte verS = sizeof(verPM);
#define ver reinterpret_cast<__FlashStringHelper *>(verPM);*/

/*inline constexpr char verC[] = "2.2." REV_ID;
inline constexpr byte verS = sizeof(verC);
inline constexpr __FlashStringHelper verF = F(verC);*/
#define STATUS_MESSAGE F(" SierraGliding Weather Station. github.com/BarryPSmith/SierraGliding for source. SierraGliding.us for location. This station identified by first three bytes=XW")

//Station Specific Constants
#ifdef STATION_ID
inline constexpr char defaultStationID = STATION_ID;
#else
inline constexpr char defaultStationID = 'Z';
#endif
extern char stationID;

//Global Constants
inline constexpr unsigned long serialBaud = 
#if defined(SERIAL_BAUD)
  SERIAL_BAUD;
#else
  38400;
#endif
inline constexpr unsigned long millisBetweenStatus = 600000; //We send our status messages every ten minutes.
inline constexpr unsigned long maxMillisBetweenPings = 1300000; //If we don't receive a ping in just under 20 minutes, we restart.
inline constexpr unsigned short batteryHysterisis_mV = 50;

#ifdef FCC_COMPLIANT
inline constexpr uint32_t defaultFreq = 917000000;
inline constexpr uint16_t defaultBw = 5000;
#else
inline constexpr uint32_t defaultFreq = 424800000;
inline constexpr uint16_t defaultBw = 625;
#endif

extern unsigned long weatherInterval; //Current weather interval.
/*extern unsigned long overrideStartMillis;
extern unsigned long overrideDuration;
extern bool overrideShort;*/
enum SleepModes { disabled = 0, idle = 1, powerSave = 2 };
extern SleepModes solarSleepEnabled;
extern SleepModes dbSleepEnabled;
extern SleepModes weatherSleepEnabled;
enum class BatteryMode { Normal, Save, DeepSleep, Stasis };
extern BatteryMode batteryMode;
extern unsigned short batteryReading_mV;
extern bool stasisRequested;

//Recent Memory
extern unsigned long lastStatusMillis;

extern unsigned long lastPingMillis;

inline unsigned short millis16()
{
  return (unsigned short)millis();
}

#if !defined(DEBUG) && !defined(MODEM)
#define LED_PIN0 0
#define LED_PIN1 1
#define LED_OFF HIGH
#define LED_ON LOW
inline void signalOff()
{
  static_assert(LED_PIN0 == 0);
  static_assert(LED_PIN1 == 1);
  static_assert(LED_ON == LOW);
  static_assert(LED_OFF == HIGH);
  PORTD |= _BV(PD0);
  PORTD |= _BV(PD1);
  //digitalWrite(LED_PIN0, LED_OFF);
  //digitalWrite(LED_PIN1, LED_OFF);
}

void signalError(uint16_t errorCode, const byte delay_ms = 100);
#define SIGNALERROR(...) signalError(__VA_ARGS__)
#else
#define SIGNALERROR(...) do {} while (0)
#endif // !DEBUG
extern bool silentSignal; 
extern unsigned short lastErrorSeconds;
extern short lastErrorCode;

#ifdef ATMEGA328PB
  const byte PRUSART1 = 4;
  extern volatile byte* PRR1;
  const byte PRTWI1 = 5;
  const byte PRPTC = 4;
  const byte PRTIM4 = 3;
  const byte PRSPI1 = 2;
  const byte PRTIM3 = 0;
  const byte ADC6D = 6;
  const byte ADC7D = 7;
#endif
