BarryPSmith/SierraGliding/RemoteStation/MessageHandling.h

#pragma once
#include "PermanentStorage.h"

namespace MessageHandling
{
  void sendStatusMessage();
  void readMessages();
  void sendWeatherMessage();
  byte getUniqueID();

  extern byte _relayBuffer[254];
  extern bool _relayNeedsResend;
  extern unsigned short _relayResendRate;

  //We keep track of recently seen stations to allow network debugging / optimisation
  struct RecentlySeenStation
  {
    byte id;
    unsigned long millis; 
    byte rssi_xn2;
    int8_t snr_x4;
  };

  struct RecentlyRelayedMessage
  {
    char type;
    byte msgID;
    byte stationID;
  };

  extern RecentlySeenStation recentlySeenStations[permanentArraySize]; //100 bytes
  //We keep track of recently relayed messages to avoid relaying the same message multiple times
  extern RecentlyRelayedMessage recentlyRelayedMessages[permanentArraySize]; //3 bytes per record: msg type, stationID, uniqueID. 60 bytes
  //Every message is given a unique ID. This is so other stations can keep track of them
  extern byte curUniqueID;
}
