BarryPSmith/SierraGliding/RemoteStation/Flash.cpp

#include "Flash.h"
#include "LoraMessaging.h"

namespace Flash
{  
  bool handleReadCommand(MessageSource& msg, const byte uniqueID, uint32_t add, bool* ackRequired);
  bool flashOK = false;
  SPIFlash flash(FLASH_SELECT, MANUFACTURER_ID);

  bool flashInit()
  {
    flashOK = flash.initialize();
    if (flashOK)
      flash.sleep();
    return flashOK;
  }

  bool handleFlashCommand(MessageSource& msg, const byte uniqueID,
    bool* ackRequired)
  {
    if (!flashOK)
      return false;
    FLASH_PRINTLN(F("Processing flash command..."));
    byte rwe;
    uint32_t add;
    if (msg.readByte(rwe) || 
        msg.read(add))
      return false;

#ifndef DEBUG
    if ((rwe == 'W' || rwe == 'E') && add < 32768)
      return false;
#endif

    flash.wakeup();
    auto ret = true;
    switch (rwe)
    { 
    case 'E':
      flash.blockErase4K(add);
      break;
    case 'W':
      byte b;
      while (!msg.readByte(b))
        flash.writeByte(add++, b);
      break;
    case 'R':
      ret = handleReadCommand(msg, uniqueID, add, ackRequired);
    }
    flash.sleep();
    return ret;
  }
  
  bool handleReadCommand(MessageSource& msg, const byte uniqueID, uint32_t add, bool* ackRequired)
  {
    //FLASH_PRINTLN(F("Flash Read"));
    byte count;
    if (msg.read(count))
      return false;

    char memType;
    if (msg.read(memType))
      memType = 'E';

    byte msgBuffer[254];
    LoraMessageDestination dest(false, msgBuffer, sizeof(msgBuffer), 'K', uniqueID);
    dest.appendByte2('F');
    dest.appendByte2('R');
    //FLASH_PRINTVAR(add);

    byte* buffer;
    if (dest.getBuffer(&buffer, count))
    {
      dest.abort();
      return false;
    }
    switch (memType)
    {
    case 'E':
    {
      flash.readBytes(add, buffer, count);
      break;
    }
    case 'I':
      if (add >= 32768 || add + count > 32768)
        return false;
      for (int i = 0; i < count; i++)
      {
        byte b = pgm_read_byte(add++);
        FLASH_PRINT(b, HEX);
        FLASH_PRINT(' ');
        dest.appendByte2(b);
      }
      break;
    case 'V':
    {
      if (add >= 2048 || add + count > 2048)
        return false;
      void* ptr = (void*)add;
      memcpy(buffer, ptr, count);
      break;
    }
    default:
      dest.abort();
      return false;
    }
    FLASH_PRINTLN();
    *ackRequired = false;
    return true;
  }
}
