BarryPSmith/SierraGliding/RemoteStation/TimerTwo.h

#include <Arduino.h>

#define MILLIS_PER_SECOND 1000UL
#define TIMER2_RESOLUTION 256UL
#ifdef CRYSTAL_FREQ
#define DIVIDER 32UL
#define TIMER2_TOP 255
#define TIMER2_TOP_ALT 244
#else
#define DIVIDER 1024UL
#define TIMER2_TOP 249
#endif

#define STR(A) #A
#define XSTR(A) STR(A)
#define XXSTR(A) XSTR(A)

struct XtalInfo
{
public:
  bool failed;
  byte test1;
  byte test2;
};

//We replace default timer2 functionality to wake up less often, or run from an external crystal
class TimerTwo
{
public:
  static constexpr unsigned long MillisPerTick = 
#ifdef CRYSTAL_FREQ
    (TIMER2_TOP + 1) * MILLIS_PER_SECOND * DIVIDER / CRYSTAL_FREQ;
#else
    (TIMER2_TOP + 1) * MILLIS_PER_SECOND * DIVIDER / F_CPU;
#endif
  static constexpr byte slowFactor = 32;
  static volatile unsigned long _ticks;
  static volatile unsigned char _ofTicks;

  static void initialise();
  // Slows the timer to run on a 1024 prescaler - this is 32x slower than usual.
  static void slowDown();

  static unsigned long millis();

  static unsigned long micros();

  static unsigned long seconds();
  static void setSeconds(unsigned long seconds);

  static XtalInfo testFailedOsc();
#ifdef CRYSTAL_FREQ
  static bool _crystalFailed;
#if F_CPU > 1000000
  static byte _subTicks;
  static constexpr byte subsPerTick = F_CPU / 1000000;
#endif
#endif
};
