BarryPSmith/SierraGliding/(commit log)

2019-09-29 Add site framework
2019-09-30 Work on dotNet_Receiver. Added arduino code (needs cleanup)
2019-10-02 Hardware: Tweaked power saving logic
2019-10-03 Arduino Software: Added interval override. Improved response to 'Q' query. Comments
2019-10-03 Wire up data selection
2019-10-04 Added wind direction and battery graphs. Probably don't want battery showing most of the time.
2019-10-05 Fix date insertion
2019-10-06 Send full data object via socket
2019-10-06 Fix a couple of JS gotchas
2019-10-06 Pass & parse all data via socket
2019-10-06 Wire up duration selection buttons
2019-10-06 Allow switching between durations
2019-10-06 Add map/list switcher
2019-10-07 Add sample URL param validity checks
2019-10-08 Separated wind and battery charts. Legend work.
2019-10-10 Secure Sockets. Spelling Error.
2019-10-19 Live battery level naming change
2019-10-31 Partial cleanup of weather station code & reduced memory consumption. Things are likely broken, needs testing.
    [ArduinoWeatherStation.h, ArduinoWeatherStation.ino, Commands.cpp, MessageHandling.cpp, MessageHandling.h, Messaging.h, WeatherProcessing.cpp]
2019-11-02 Changed ArduinoWeatherStation to use NMAKE rather than Arduino IDE.
2019-11-10 Reworked arduino code for streaming messages. Changed constants for station #2.
    [ArduinoWeatherStation.cpp, ArduinoWeatherStation.h, Commands.cpp, MessageHandling.cpp, MessageHandling.h, Messaging.h, WeatherProcessing.cpp, WeatherProcessing.h]
2019-11-15 Work on the arduino software. Also an arduino Kiss Modem.
2019-11-16 Cleanup. Changed to use submodule for Low-Power library.
2019-11-16 Changed TimerOne to submodule
2019-11-16 Made everything work of Timer1 millis. Added debounce to windspeed logic.
2019-11-16 Updated battery voltage calcs
2019-11-19 A bunch of changes. Most significantly, made the modem use DIO2 as a RF switch. Tried to add Moteino support with the RF96 module. No luck yet. Some other stuff
2019-11-20 Website bugfixes. Weather station stuff but I forget what.
    [KissModem.cpp]
2019-11-20 Clawing memory back using F(...)
2019-11-28 Changed to Timer2 so we can put the ATMega to sleep
2019-12-10 Fixed for the SX1278
    [LoraMessaging.cpp]
2019-12-10 Fixed overflow in winddspeed calc
    [WeatherProcessing.cpp]
2019-12-11 Customisable battery range. Switched erratic time behaviour when switching between battery and wind.
2019-12-15 Fixed windspeed calc. Receiver-side fix for now too.
    [WeatherProcessing.cpp]
2019-12-23 Weather Station: Added watchdog timer Added ping checks Added signalError when not compiled in DEBUG Messaging init will retry until no error code is returned Added light signal when sending message 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
    Receiver:
    Added pings
    Improved console redirect
    Can now send commands to the modem
    [ArduinoWeatherStation.cpp, ArduinoWeatherStation.h, KissModem.cpp, LoraMessaging.cpp, LoraMessaging.h, MessageHandling.cpp, MessagingCommon.cpp]
2019-12-24 Fixed a couple bugs in millis and micros implementations
    [MessageHandling.cpp, TimerTwo.cpp, TimerTwo.h]
2019-12-31 Made reset work even when we can't properly use WDT because of crappy old bootloader. Implemented stack trace reporting after a crash.
    [ArduinoWeatherStation.cpp, LoraMessaging.cpp, StackCanary.cpp]
2020-01-06 Fixed a problem with the naked watchdog ISR causing erratic behaviour with 'return'. More makefile work
    [CSMA.h, KissModem.cpp, LoraMessaging.cpp, StackCanary.cpp, StackCanary.h, WeatherProcessing.cpp]
2020-01-12 Added some power saving stuff, disabled for now. This image should be run at Flynns for a while
2020-01-23 Added Eagle design. Cleaned up hardware.
    [Weather Station.brd, Weather Station.sch]
2020-01-25 Added temperature sense. MCU sleeps more.
2020-01-28 Fixed sleep logic Decreased radio transition times Changed default spreading factor Fixed internal temperature calibration Fixed lack of length prepending weather messages Changed diode for TL431 (TO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
    [Weather Station.brd, Weather Station.sch]
2020-01-28 Added wind calibration. Started using namespaces. Added indicator LEDs
    [Weather Station.brd, Weather Station.sch]
2020-01-28 Cleaned up commands, added weather calibration commands.
2020-02-03 Build parameter adjustment for Mt Tom board
2020-02-03 More Mt Tom fixes.
    [WeatherProcessing.cpp]
2020-02-08 Added battery & temperature to server and website. Fixed Bugs with argent data wind calculation.
    [WeatherProcessing.cpp]
2020-02-10 Fixed a bug in weather relay. Made receiver more resilient to this bug.
    [Commands.cpp, LoraMessaging.cpp, MessageHandling.cpp]
2020-02-13 Fixed some wind direction rounding
    [WeatherProcessing.cpp]
2020-02-17 Remote Programming implemented (not connected). Tweaked relay logic.
2020-02-18 Added PWM charge control circuitry
    [Weather Station.brd, Weather Station.sch]
2020-02-23 Added stationID to EEPROM and made changeable. Some hardware work.
    [Weather Station.brd, Weather Station.sch]
2020-02-25 Switched to DRF126xT module
    [Weather Station.brd, Weather Station.sch]
2020-02-29 Added server side WS electrical noise filtering. Fixed a bug in battery chart.
2020-03-01 Fixed a bug where packets were still handled even if they failed their CRC check. Improved receiver logging (now logs non-weather packets to SQLite). Can now query modem for stats.
    [CSMA.h, KissModem.cpp, LoraMessaging.cpp, LoraMessaging.h, MessageHandling.cpp]
2020-03-09 Improved ping. Added ability to read current image from stations.
2020-03-10 Fixed a bug in remote programming. Improved debug print macros. Added wind direction averaging.
    [ArduinoWeatherStation.cpp, ArduinoWeatherStation.h, RemoteProgramming.cpp, WeatherProcessing.cpp, WeatherProcessing.h]
2020-03-15 Better speed formatting for null values; Some other stuff
    [Weather Station.brd, Weather Station.sch]
2020-04-02 Version 2.2 Added solar PWM control Added new board to boards.makefile (7)
2020-04-03 Cleaned up weather sensing a little. Added ALS wind sensor option. Now too big to compile in debug.
    [ADWind.cpp, ALSWind.cpp, ArduinoWeatherStation.cpp, Commands.cpp, DavisWind.cpp, MessageHandling.cpp, PWMSolar.cpp, WeatherProcessing.cpp]
2020-04-03 Clawed back some space
2020-04-04 Cleanup and minor bug fixes
    [ADWind.cpp, ALSWind.cpp, ArduinoWeatherStation.cpp, ArduinoWeatherStation.h, DavisWind.cpp, PermanentStorage.cpp, WeatherProcessing.cpp, WeatherProcessing.h]
2020-04-05 Receiver improvements. Fixed a problem trying to adjust temp sense gain.
    [ADWind.cpp, PWMSolar.cpp, WeatherProcessing.cpp, WeatherProcessing.h]
2020-04-09 ALS Wind direction bug fixes. Added ability to chain receivers using UDP. QueryVolatileResponse bugfix.
    [Weather Station.brd, Weather Station.sch]
2020-04-11 Power saving fixed relay commands & mustRelay logic PWM debugging Receiver: Added ability to send modem commands over UDP
    [ArduinoWeatherStation.cpp, CSMA.h, Commands.cpp, LoraMessaging.cpp, LoraMessaging.h, MessageHandling.cpp, MessageHandling.h, PermanentStorage.cpp]
2020-04-11 Bugfixes in PWM debugging
    [PWMSolar.cpp, WeatherProcessing.cpp]
2020-04-14 Added more power saving options: Disable continuous receive & deep sleep, clock divider Receiver: Ability to handle extra bytes on weather packets
2020-04-19 Fixed (?) website performance issues. Added idling.
    [ArduinoWeatherStation.cpp, ArduinoWeatherStation.h, PWMSolar.cpp]
2020-05-01 Added magnetic direction sensor board
    [Magnetic Direction Sensor.brd, Magnetic Direction Sensor.sch]
2020-05-01 Made single board design
    [Single_Board.brd, Single_Board.sch]
2020-05-01 More PCB work
    [Single_Board.brd]
2020-05-02 Hardware work. Added elevation to station meta data
    [Magnetic Direction Sensor.brd, Single_Board.brd, Single_Board.sch, Single_Board_BOM.csv, Single_Board_Centroids.csv]
2020-05-11 Added asynchronous Timer2 code
2020-05-12 Station backward compatibility fixes. Site: Can now request hidden stations, made temperature chart sizeable on click.
    [ArduinoWeatherStation.cpp, DavisWind.cpp, PermanentStorage.cpp, RemoteProgramming.cpp, TimerTwo.cpp, WeatherProcessing.cpp]
2020-05-18 Hardware changes associated with new boards.
2020-05-22 Reduced wind sampling on every speed tick. Enabled PWM adjustment in yield()
2020-05-23 Improved ability of modem to receive from radio and serial simultaneously. Fixed a bug in CSMA message queue.
    [ArduinoWeatherStation.h, CSMA.h, KissMessaging.cpp, KissModem.cpp, LoraMessaging.h]
2020-05-23 More bugfixes with CSMA queueing Added GUIDs to UDP packets to avoid repeated processing
    [ArduinoWeatherStation.h, CSMA.h, KissModem.cpp]
2020-05-24 fixed a bug with macro definition minor code space improvements
    [ArduinoWeatherStation.h, Commands.cpp, KissMessaging.cpp, KissModem.cpp, LoraMessaging.cpp, LoraMessaging.h, MessageHandling.cpp, MessagingCommon.cpp]
2020-05-31 Renamed ArduinoWeatherStation to reflect that it doesn't use Arduino
    [ADWind.cpp, ALSWind.cpp, ArduinoWeatherStation.cpp, ArduinoWeatherStation.h, CSMA.h, Commands.cpp]
2020-05-31 ArduinoCore-avr is now a submodule. Added avdude patch
2020-06-06 Bugfix in default station ID
    [PermanentStorage.cpp]
2020-08-06 Separated Flynns and Mt Tom builds Tweaked TX params Fixed very high wind gusts reported after restart Simplified adding new stations to Windy All stations now report gust
    [PermanentStorage.cpp, WeatherProcessing.cpp]
2020-08-20 Now relays S type messages
2020-09-04 Fixed a bug where once a messaging reinitialise was triggered, it would fire every loop
    [ArduinoWeatherStation.cpp, LoraMessaging.h]
2020-09-04 Added command guards. Saves stack trace on reboot.
    [ArduinoWeatherStation.cpp, Commands.cpp, Database.cpp, Database.h, KissMessaging.cpp, KissMessaging.h, LoraMessaging.cpp, LoraMessaging.h]
2020-09-05 Forgot to store stack pointer with self storage of stack trace.
2020-09-05 Programmer fixes with new extra CRC checks
    [ArduinoWeatherStation.cpp]
2020-09-05 Fixed checks for zeros in uninitalised memory. NFI how it was working
    [ArduinoWeatherStation.cpp, ArduinoWeatherStation.h, Database.cpp]
2020-09-19 Database list messages less likely to collide with their relays. Remote programmer aware of command CRCs.
    [Database.cpp]
2020-11-29 Reworked board to put more components on bottom side (=less soldering)
    [Single_Board.brd, Single_Board.sch]
2020-12-08 Added daylight indicators
    [Single_Board.brd, Single_Board.sch]
2020-12-08 Bump dot-prop from 4.2.0 to 4.2.1 in /web/site
    Bumps [dot-prop](https://github.com/sindresorhus/dot-prop) from 4.2.0 to 4.2.1.
    - [Release notes](https://github.com/sindresorhus/dot-prop/releases)
    - [Commits](https://github.com/sindresorhus/dot-prop/compare/v4.2.0...v4.2.1)
2021-01-01 Station improvements. Multi-subpacket handling in receiver. Out of order packets in site datamanager.
    [Single_Board.brd, Single_Board.sch]
2021-01-23 Added config for new board Updated Solar PWM for current sensor and impedance switching Fixed a bug with internal termperature sense Added more charge info to detailed weather messages Added support 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
    [Single_Board.brd, Single_Board.sch, Single_Board_BOM.csv, Single_Board_Centroids.csv]
2021-01-23 Pwm and current now sent to server.
2021-02-04 Minor fixes for new board Added ability to read volatile memory Added ability to toggle SX switch power for debugging Fixed and improved current based PWM limiting
    [ArduinoWeatherStation.cpp, Flash.cpp, LoraMessaging.cpp, PWMSolar.cpp, PWMSolar.h, PermanentStorage.h, RemoteProgramming.cpp, WeatherProcessing.cpp]
2021-02-13 Removed Interval override Added magnetic sensor calibration Fixed a bug in reading the low four bits of the direction sensor Experimented with using the ALS31313 for internal temperature - no good
    [ALSWind.cpp, ArduinoWeatherStation.cpp, ArduinoWeatherStation.h, Commands.cpp, Flash.cpp, PWMSolar.cpp, PermanentStorage.cpp, PermanentStorage.h]
2021-02-14 Saving program space: Removed many icalls Switched to home-brew synchronous two wire
2021-03-07 Stations: Removed a bunch of icalls Stations: Removed dependence on bloated Arduino I2C library Website: Fixed a bug where stations don't update until expanded Website: Unexpanded stations will displ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
    [ALSWind.cpp, ArduinoWeatherStation.cpp, ArduinoWeatherStation.h, Commands.cpp, LoraMessaging.cpp, LoraMessaging.h, TimerTwo.cpp, TimerTwo.h]
2021-03-17 Removed remote switch control. Debug parameters changed.
2021-03-20 v2.4: Added DB info to QV message Info from crystal tests improved Crystal test on startup Bugfix: Database search is aware of old bug that didn't properly fill pages
    [ArduinoWeatherStation.cpp, ArduinoWeatherStation.h, Commands.cpp, Database.cpp, Database.h, TimerTwo.cpp, TimerTwo.h]
2021-03-20 Added board number to version string
2021-03-20 Database bugfix & improvements Bugfixes with non-XTAL & Davis wind station (Flynns)
    [Database.cpp, DavisWind.cpp, TimerTwo.cpp]
2021-03-23 Found a problem where the solar PWM can latch closed. Temporary fix is to set an appropriate startup value that doesn't close it.
    [ArduinoWeatherStation.cpp, ArduinoWeatherStation.h, PWMSolar.cpp, WeatherProcessing.cpp]
2021-04-02 Board improvements: Current sensor less prone to latchup Reset pull up resistor JST SH battery connector 8p8c connector to remove shared grounds NPN transistor so we don't operate the mcu outside of 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
    [Single_Board.brd, Single_Board.sch]
2021-04-04 Added old centroid file purely for history
    [Single_Board_Centroids2.csv]
2021-04-04 Board work for sending off
    [Single_Board.brd, Single_Board.sch, Single_Board_BOM.csv, Single_Board_Centroids.csv, Single_Board_Centroids2.csv]
2021-04-28 Added build parameters for new board & 915MHz band Added way to test magnetic field strength
2021-05-05 Board improvements: Fixed 8P8C jack footprint. Better antenna trace impedance. Added anti-static resistor to antenna
    [Single_Board.brd, Single_Board.sch]
2021-11-01 Modem automatically restarts the radio if it doesn't receive a message in 6 seconds Stations select default frequency and bandwidth if frequency is out of range Fixed a bug with weather relay overflo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
    [ArduinoWeatherStation.h, CSMA.h, KissModem.cpp, LoraMessaging.cpp, MessageHandling.cpp, PermanentStorage.cpp, WeatherProcessing.cpp]
2021-12-06 Improved low battery behaviour Added configurable inbound preamble length Improved modem behaviour in the event of CRC mismatches
2021-12-07 Cleaned up and improved battery management.
2021-12-08 Fixed a uninitalised pointer and threading bug introduced in previous commit.ISP programming now preserves EEPROM
    [LoraMessaging.h]
2021-12-08 Fixed bug that made it impossible to exit stasis. Minor space saving by moving message initialisation into the constructor.
    [ArduinoWeatherStation.cpp, Commands.cpp, Database.cpp, Flash.cpp, LoraMessaging.cpp, LoraMessaging.h, MessageHandling.cpp, RemoteProgramming.cpp]
2021-12-08 Re-enabled modem watchdog Inbound preamble length reset to 8 in low power modes Improved receiver logging
    [KissModem.cpp, LoraMessaging.h]
2021-12-09 Fixed bugs and simplified weather relay
    [MessageHandling.cpp]
2021-12-11 Increased CSMA maximum delay to deal with problems seen at larger SFs Fixed a bug where changed weather interval didn't take effect until a battery state change occurred Re-introduced 6 second radio 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
    [CSMA.h, Commands.cpp, KissModem.cpp, MessageHandling.cpp, WeatherProcessing.cpp, WeatherProcessing.h]
2021-12-11 Test function in receiver Debugging to try figure out what's going on with relays sometimes sending invalid data Misc formatting & display
2021-12-11 Improved gust calculation to use 4 rotations rather than 1. Webserver refuses packets with inverted windspeed / gust.
    [WeatherProcessing.cpp]
2021-12-12 Modem now sends CRC failed packets with an indicating flat, and receiver handles. Stations have adjustable coding rate.
    [ArduinoWeatherStation.h, CSMA.h, KissMessaging.cpp, KissMessaging.h, KissModem.cpp, LoraMessaging.cpp, LoraMessaging.h, PermanentStorage.cpp]
2021-12-12 Stations: Can again compile station code (previous changes for modem broke stations) Stations: Fixed gust code (== occurs before &) Receiver: Fixes. Improved post error display
    [CSMA.h, WeatherProcessing.cpp]
2021-12-14 The eternal struggle with memory. Fixed a bug where the current read packet could get corrupted when a packet is sent. Fixed a problem with buffer overrun when recording messages for relay Improved r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
    [ArduinoWeatherStation.cpp, CSMA.h, LoraMessaging.cpp, LoraMessaging.h, MessageHandling.cpp, MessageHandling.h]
2021-12-15 Fixed showstopper in previous commit that broke LoRa messaging. Minor improvements to receiver. Forgot many files for a while...
    [LoraMessaging.cpp, LoraMessaging.h, MessageHandling.cpp]
2021-12-16 Signal error now encodes the error code in the LED flashes Trying to fix an unknown error where the station stops hearing anything Receiver: Improved attempt to determine actual packet time for relay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
    [ALSWind.cpp, ArduinoWeatherStation.cpp, ArduinoWeatherStation.h, CSMA.h, Database.cpp, DavisWind.cpp, ErrorCodes.h, LoraMessaging.cpp]
2021-12-16 Fixed bugs in CSMA dequeue logic.
    [ArduinoWeatherStation.h, CSMA.h, DavisWind.cpp, ErrorCodes.h, LoraMessaging.cpp]
2021-12-18 Stations now report their last error with each extended message Stations now timestamp all weather packets Tightened CSMA Checked Out logic to avoid stations becoming deaf Pings are now checked again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
    [ArduinoWeatherStation.cpp, ArduinoWeatherStation.h, CSMA.h, Commands.cpp, LoraMessaging.cpp, LoraMessaging.h, MessageHandling.cpp]
2021-12-25 Charge current is now displayed on website where available.
2021-12-31 Added PWM to current display
2022-01-01 Database search messages no longer static (to save memory)
    [Database.cpp]
2022-01-02 Fixed a bug when running at 8MHz / no clock divider Replaced 32bit random with 16bit rand Stopped signalError messing with CSMA timing Fixed signalError not signalling the sign bit Many instances of 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
    [ArduinoWeatherStation.cpp, ArduinoWeatherStation.h, CSMA.h, Commands.cpp, Database.cpp, ErrorCodes.h, LoraMessaging.cpp, LoraMessaging.h]
2022-01-02 Added relay repeat info to QV Added relay repeat config Reworked permanent storage for upgrades
    [Commands.cpp, LoraMessaging.cpp, MessageHandling.cpp, MessageHandling.h, PermanentStorage.cpp, PermanentStorage.h]
2022-01-19 Improved PWM logic when there is no current sensor to set PWM full at night Added 'dark' option that doesn't light up any LEDs
    [ArduinoWeatherStation.cpp, LoraMessaging.h]
2022-01-23 Button font size
2022-01-24 Button tooltips
2023-07-10 Fixed a bug where ANY windspeed greater than 125km/h is report as 285km/h
    [WeatherProcessing.cpp]
2023-08-02 Timestamps for averaged data are now properly at the end of their sample period
2025-05-01 Added recommendation to switch to maps for approach info
2025-05-04 Auto-add copy buttons to coordinates in site infos. Improved infos + weather close behaviour.
2026-02-04 Added support for WS80 params to server. Added filtering for better behaviour with redundant receivers
2026-02-04 Pushed humidity, light, UV, external battery through to UI
2026-02-05 WS80 changes to make it work on a board
2026-02-05 Turned out I don't have any rev3 boards, so the new station will be on Rev2
2026-03-02 Added support for dual weather. Improved behaviour when WS80 fails.
    [ArduinoWeatherStation.cpp, ArduinoWeatherStation.h, PermanentStorage.cpp, PermanentStorage.h, WeatherProcessing.cpp, WeatherProcessing.h, Wind.h]
2026-03-02 Modem debug. WS80 stuff that should have been commited a couple commits back.
